Username0240/Corolla-AE101-Speeduino-Instrument-Cluster/Image/20260829_134153.jpg

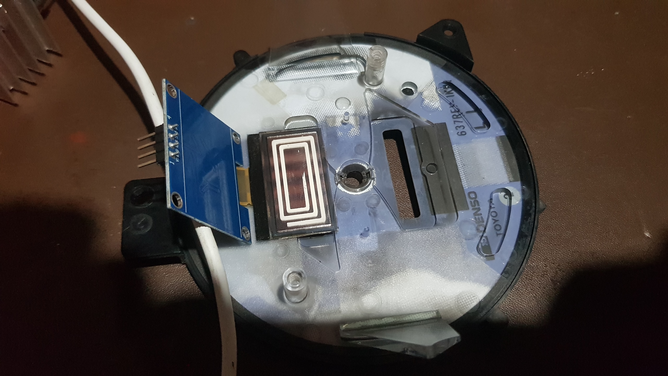
Image/20260829_134153.jpg
