Username0240/Corolla-AE101-Speeduino-Instrument-Cluster/Image/20260829_153902.jpg

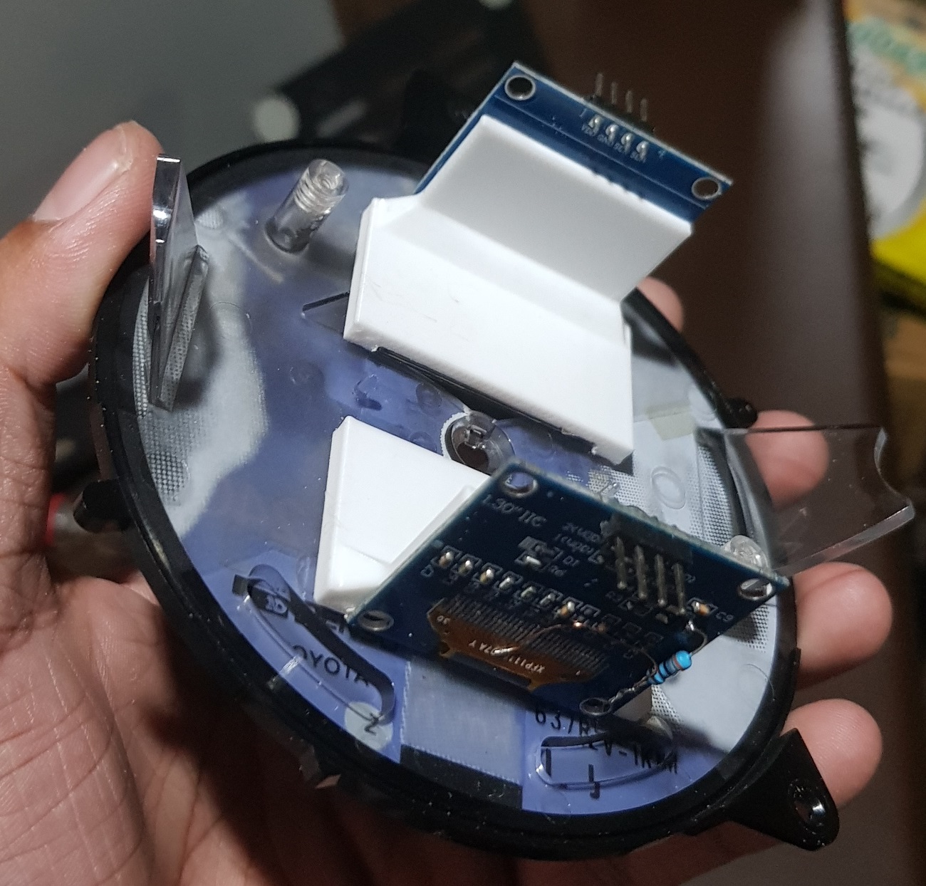
Image/20260829_153902.jpg
