Username0240/Corolla-AE101-Speeduino-Instrument-Cluster/90degreebracketcorolla.stl

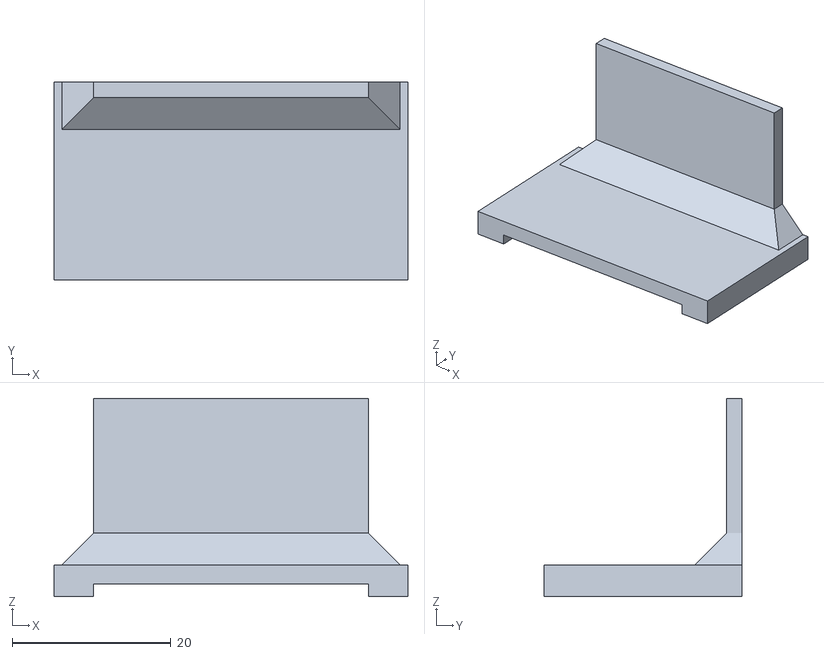
[picture p17: CAD file, 2026-08-31]
90degreebracketcorolla.stl
44.6 x 25.0 x 25.0
