Username0240/Corolla-AE101-Speeduino-Instrument-Cluster/Schematic/InstrumentClusterAE101.pdf

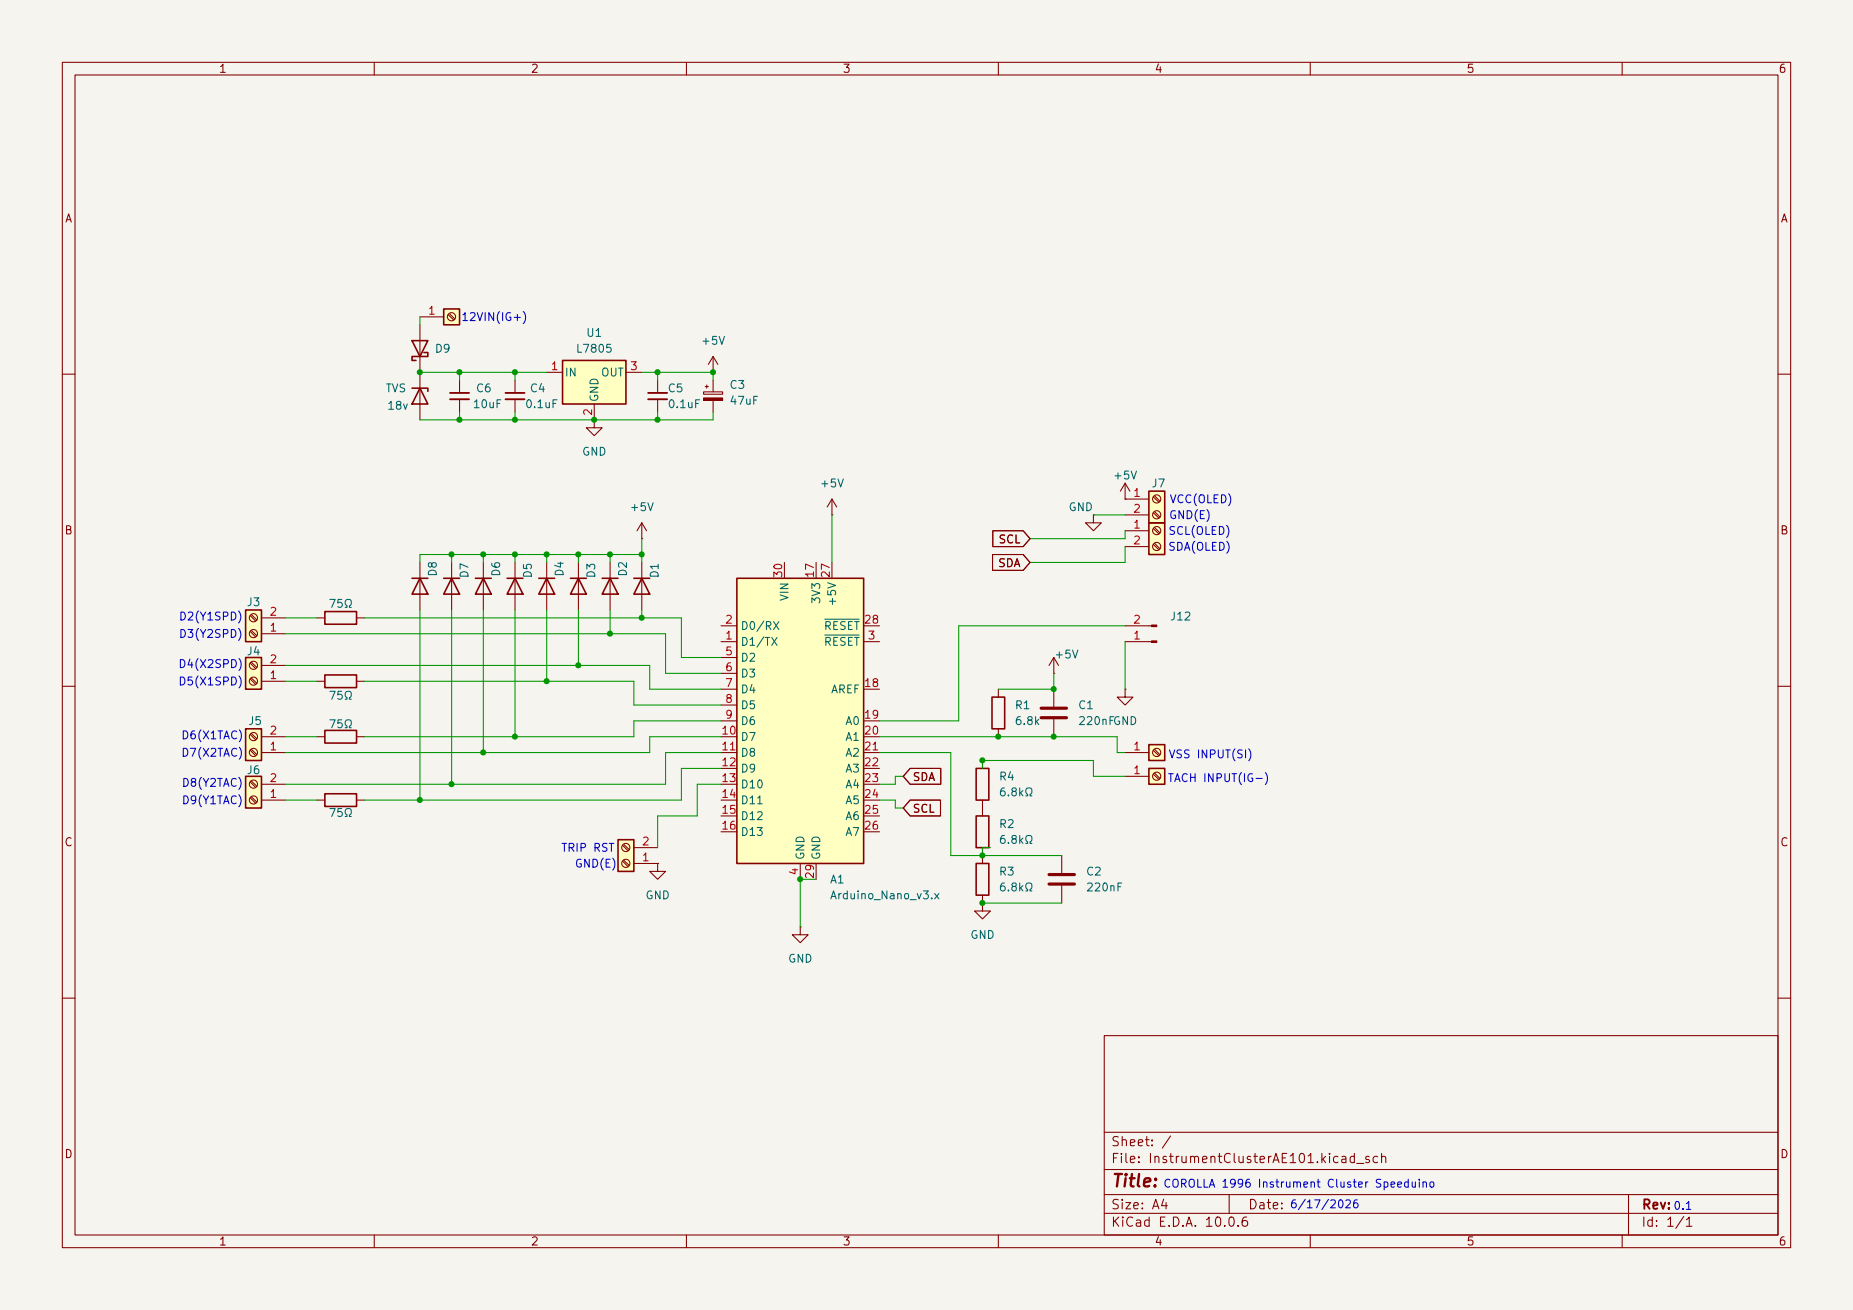
[picture p18: page 1]
