Username0240/Corolla-AE101-Speeduino-Instrument-Cluster/Schematic/InstrumentClusterAE101.kicad_sch

## KiCad design Schematic/InstrumentClusterAE101.kicad_sch (2026-08-31)

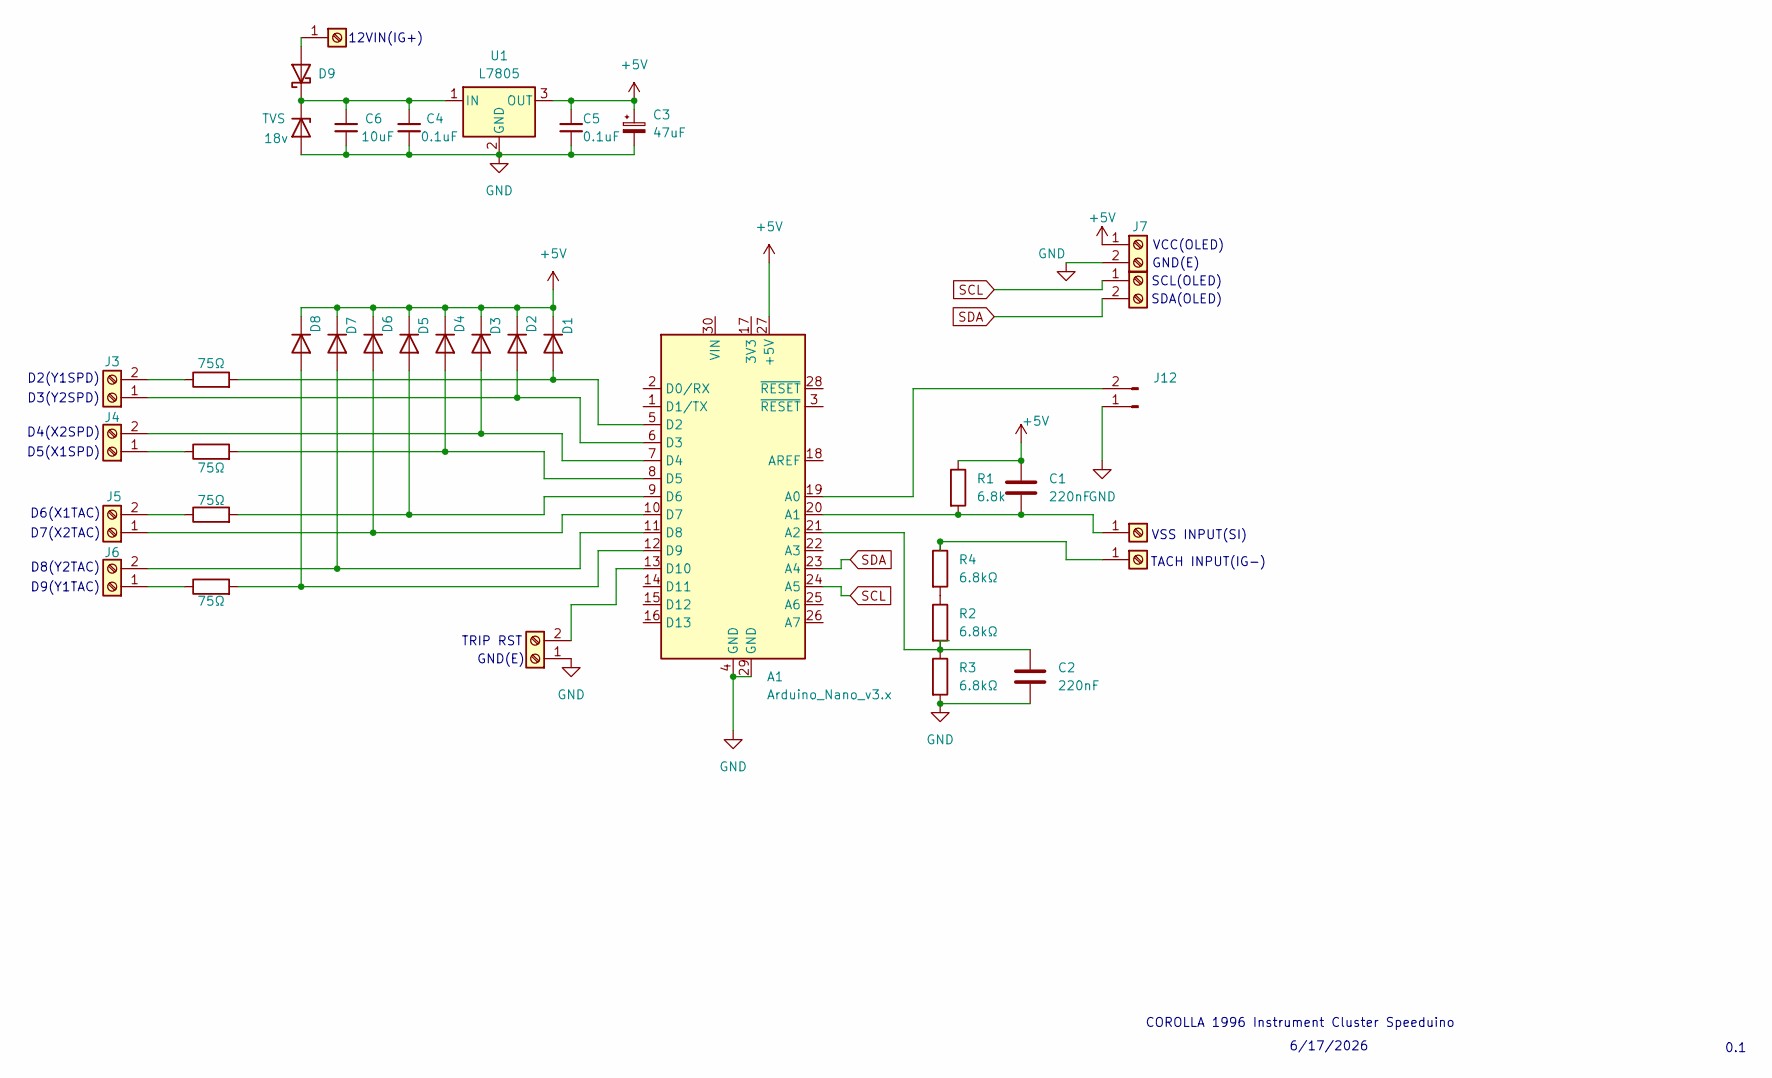
[picture p19: schematic InstrumentClusterAE101.kicad_sch]

Parts:
A1: Arduino_Nano_v3.x; Arduino_Nano
C1, C2: 220nF
C3: 47uF
C4, C5: 0.1uF
C6: 10uF
D1, D2, D3, D4, D5, D6, D7, D8: 1N4001; D_DO-41_SOD81_P10.16mm_Horizontal
D9: D_Schottky; Nexperia_DSN1608-2_1.6x0.8mm
J1: VSS INPUT
J2: TACH INPUT
J3, J4, J5, J6, J7, J8, J11: D2
J10: IG+
J12: Conn_01x02_Pin
R1: 6.8k
R2, R3, R4: 6.8kΩ
R5, R6, R7, R8: 75Ω
TVS: 18v; Nexperia_DSN1608-2_1.6x0.8mm
U1: L7805; Texas_EUW_R-PDSS-T7_THT

Connections:
+5V: A1.27 (+5V), C1.1, C3.1, C5.1, D1.1 (K), D2.1 (K), D3.1 (K), D4.1 (K), D5.1 (K), D6.1 (K), D7.1 (K), D8.1 (K), J7.1, R1.1, U1.3 (OUT)
GND: A1.4 (GND), A1.29 (GND), C2.2, C3.2, C4.2, C5.2, C6.2, J7.2, J11.1, J12.1, R3.2, TVS.2 (A), U1.2 (GND)
unnamed: A1.5 (D2), D1.2 (A), R5.2
unnamed: A1.6 (D3), D2.2 (A), J3.1
unnamed: A1.7 (D4), D3.2 (A), J4.2
unnamed: A1.8 (D5), D4.2 (A), R6.2
unnamed: A1.9 (D6), D5.2 (A), R7.2
unnamed: A1.10 (D7), D6.2 (A), J5.1
unnamed: A1.11 (D8), D7.2 (A), J6.2
unnamed: A1.12 (D9), D8.2 (A), R8.2
unnamed: A1.13 (D10), J11.2
unnamed: A1.19 (A0), J12.2
unnamed: A1.20 (A1), C1.2, J1.1, R1.2
unnamed: A1.21 (A2), C2.1, R2.2, R3.1
unnamed: C4.1, C6.1, D9.1 (K), TVS.1 (K), U1.1 (IN)
unnamed: D9.2 (A), J10.1
unnamed: J2.1, R4.1
unnamed: J3.2, R5.1
unnamed: J4.1, R6.1
unnamed: J5.2, R7.1
unnamed: J6.1, R8.1
unnamed: R2.1, R4.2
SCL: A1.24 (A5), J8.1
SDA: A1.23 (A4), J8.2

Notes on the sheet:
6/17/2026
D8(Y2TAC)
D2(Y1SPD)
D3(Y2SPD)
TACH INPUT(IG-)
GND(E)
12VIN(IG+)
VCC(OLED)
D6(X1TAC)
TRIP RST
0.1
VSS INPUT(SI)
D7(X2TAC)
COROLLA 1996 Instrument Cluster Speeduino
SDA(OLED)
D4(X2SPD)
D9(Y1TAC)
SCL(OLED)
D5(X1SPD)
