Username0240/Corolla-AE101-Speeduino-Instrument-Cluster/(commit log)

2026-08-31 Enhance README with OLED mounting information
    Added details about custom 3D-printed OLED mounting and fitment issues.
2026-08-31 Expand README with circuit building instructions
    Added detailed instructions for building the circuit, including schematic and protoboard pinout information.
2026-08-31 Revise README with instrument cluster and air-core details
    Updated the README to include detailed information about the instrument cluster connection and the air-core motor pinout.
2026-08-31 Fix directory name from '/Schematics' to '/Schematic'
